bcrepeauac/Current-DAC-Shield/README.md

# Current-DAC-Shield
Current D-A Shield for Arduino
