bcrepeauac/Current-DAC-Shield/Board Files/Rev B/DAC Shield Rev B.pdf

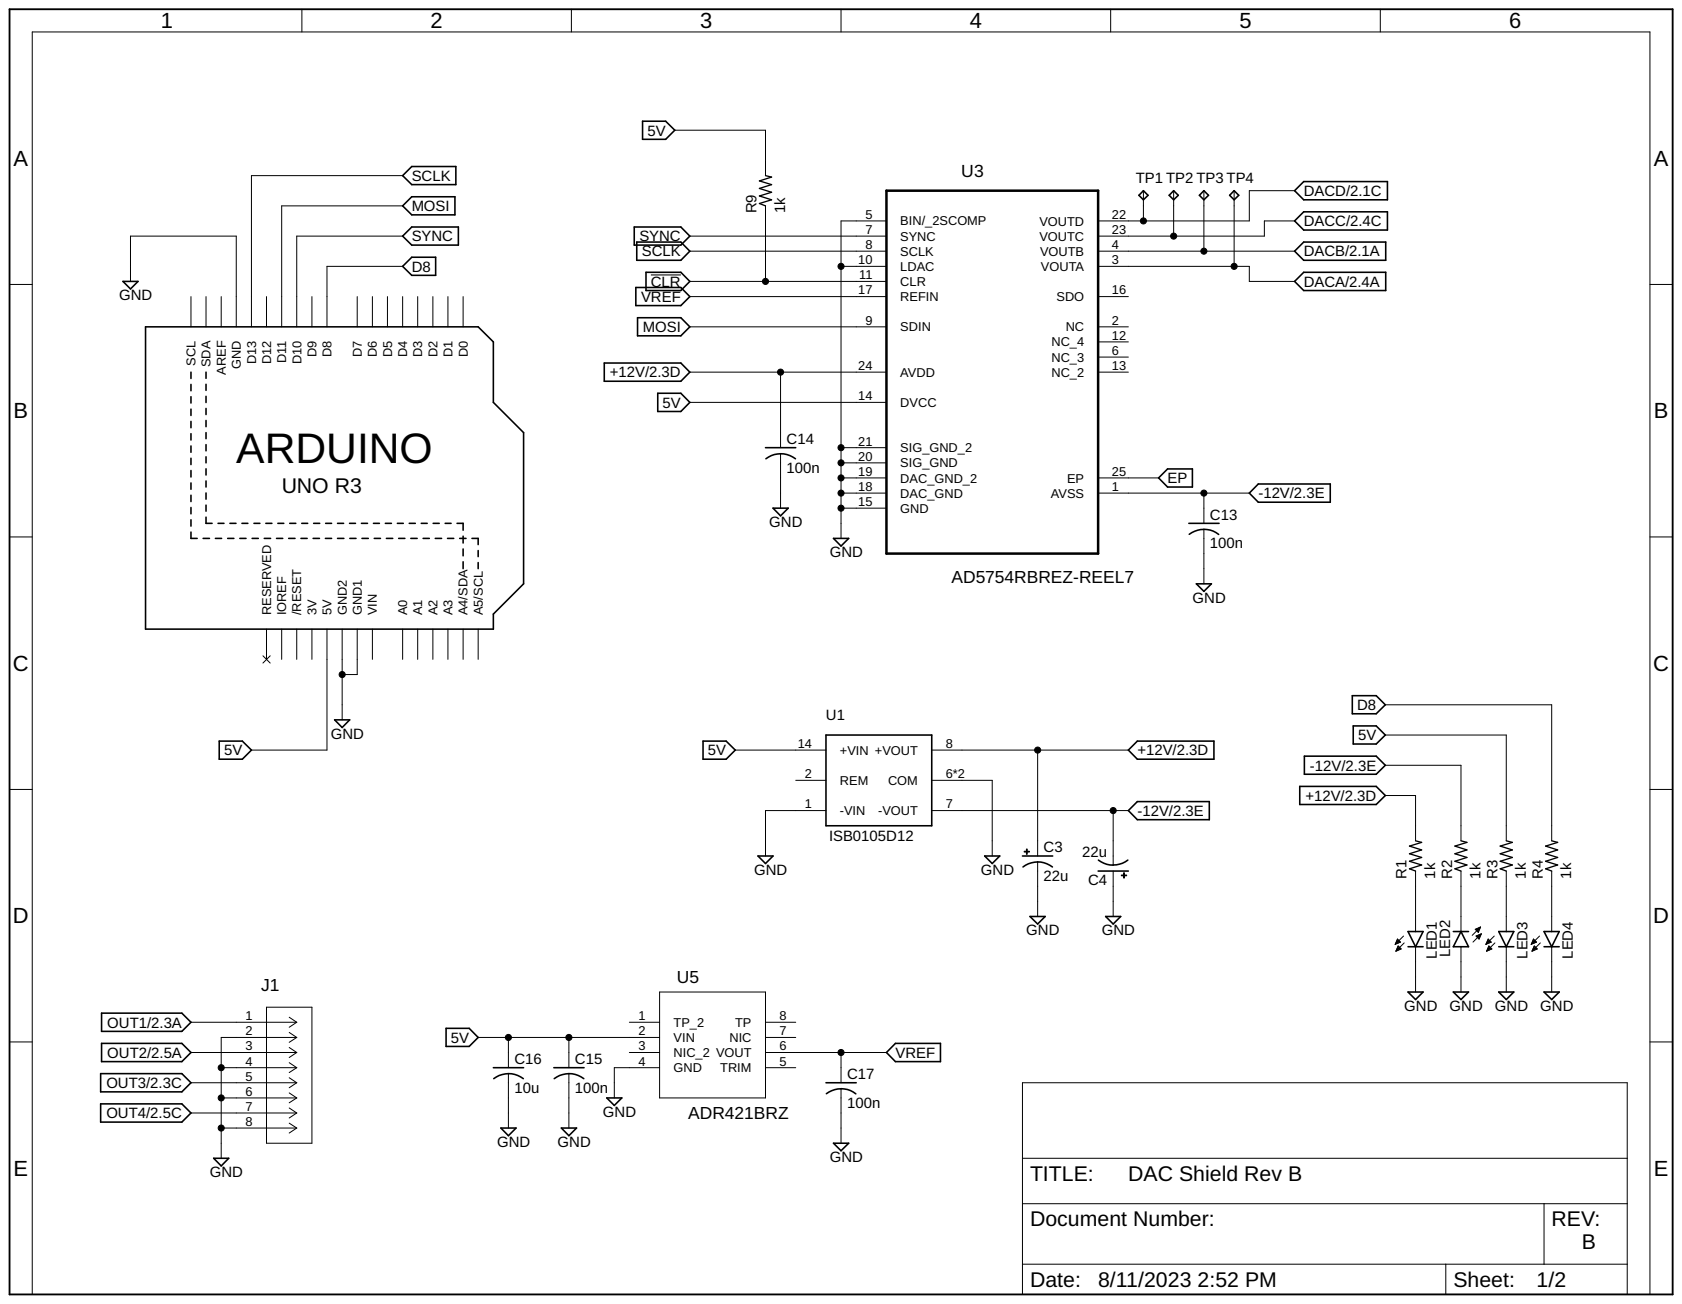
[picture p1: page 1]

GND GND

Document Number: | REV: B

Date: 8/11/2023 2:52 PM | Sheet: 1/2

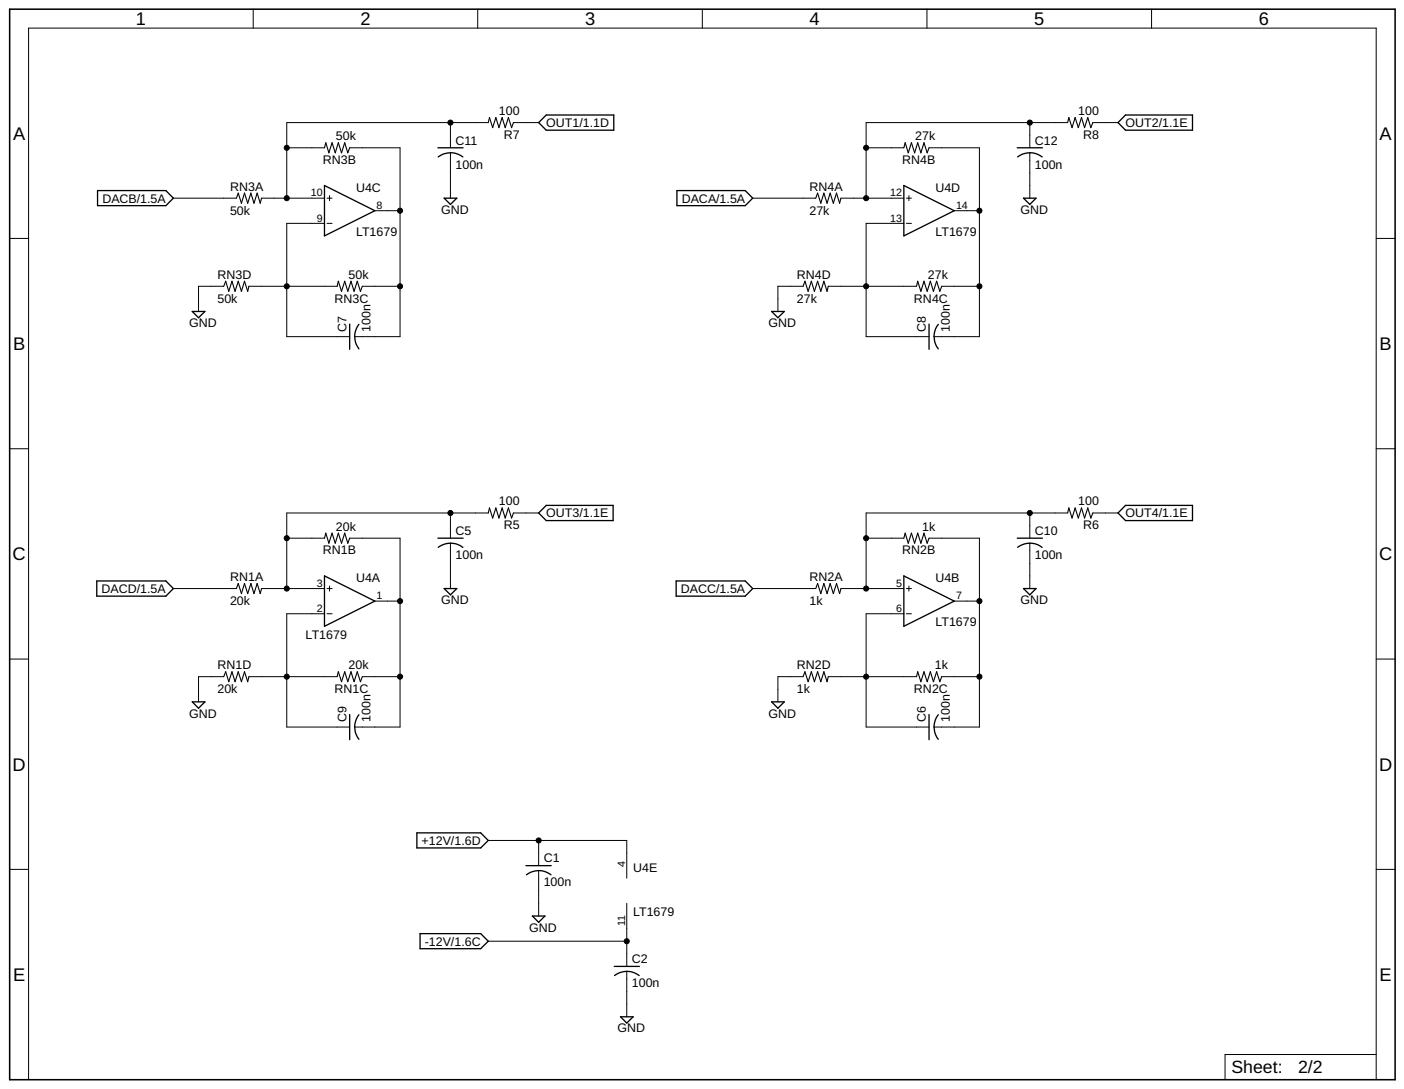
[picture p2: page 2]
