bcrepeauac/Current-DAC-Shield/Board Files/Rev -/DAC Shield.pdf

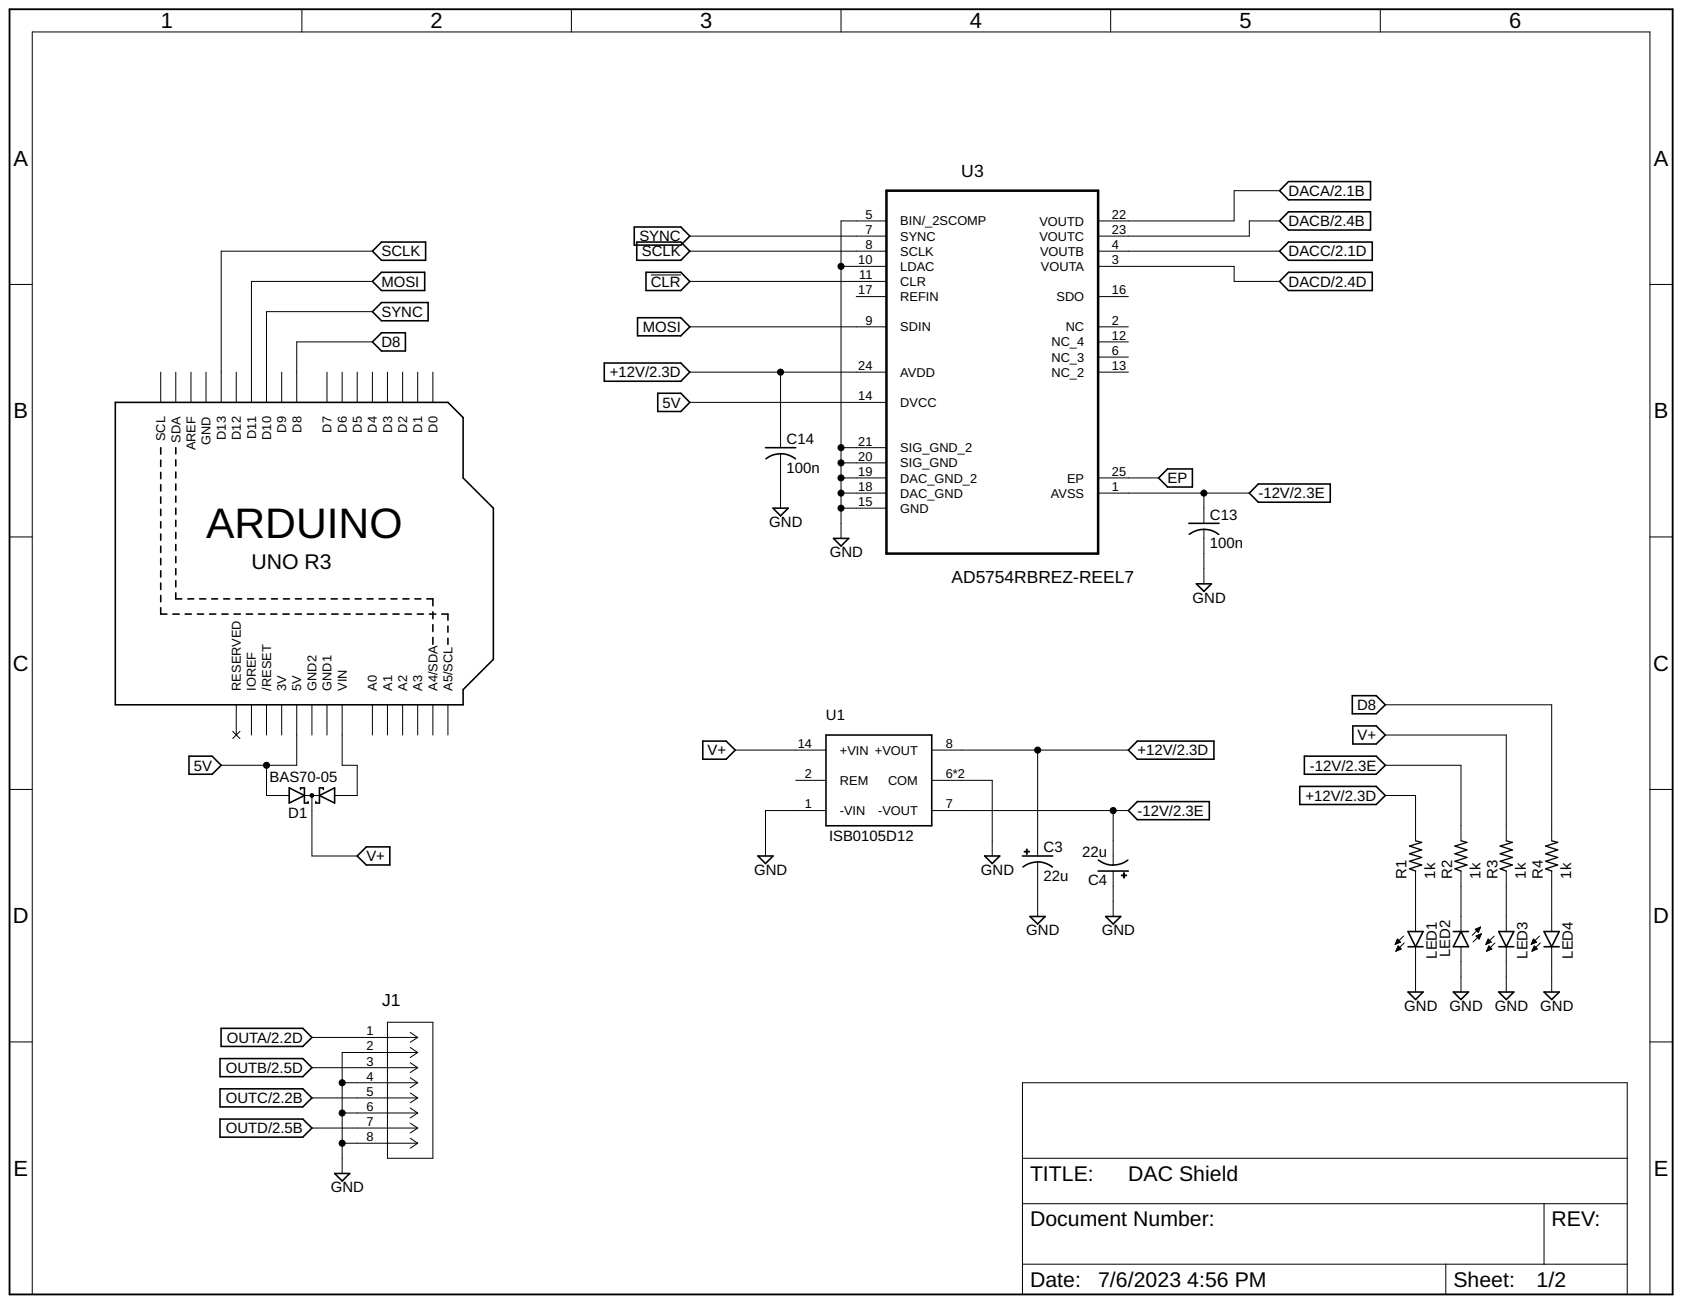
[picture p3: page 1]

GND GND

Document Number: | REV:

Date: 7/6/2023 4:56 PM | Sheet: 1/2
