bcrepeauac/Current-DAC-Shield/Board Files/Rev A/DAC Shield Rev A.pdf

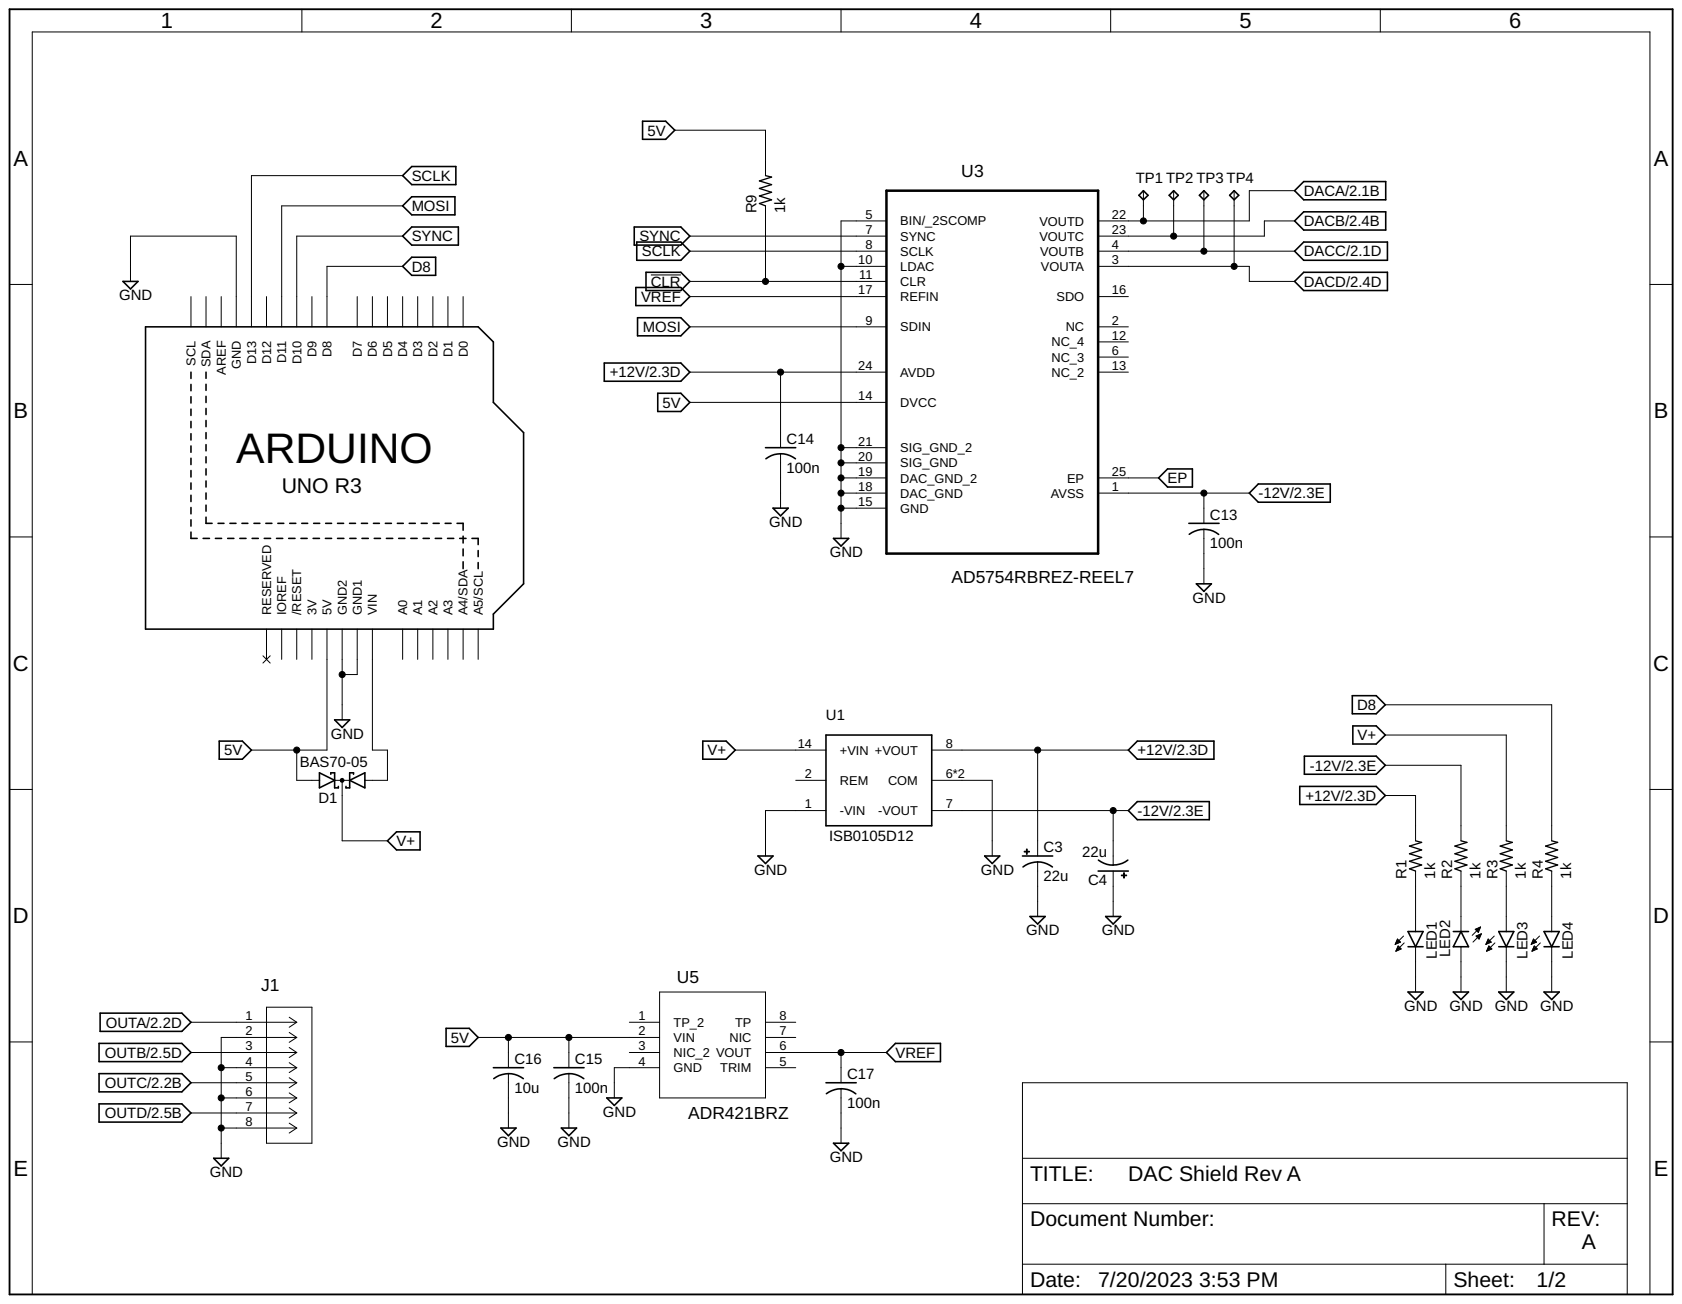
[picture p4: page 1]

GND GND

Document Number: | REV: A

Date: 7/20/2023 3:53 PM | Sheet: 1/2

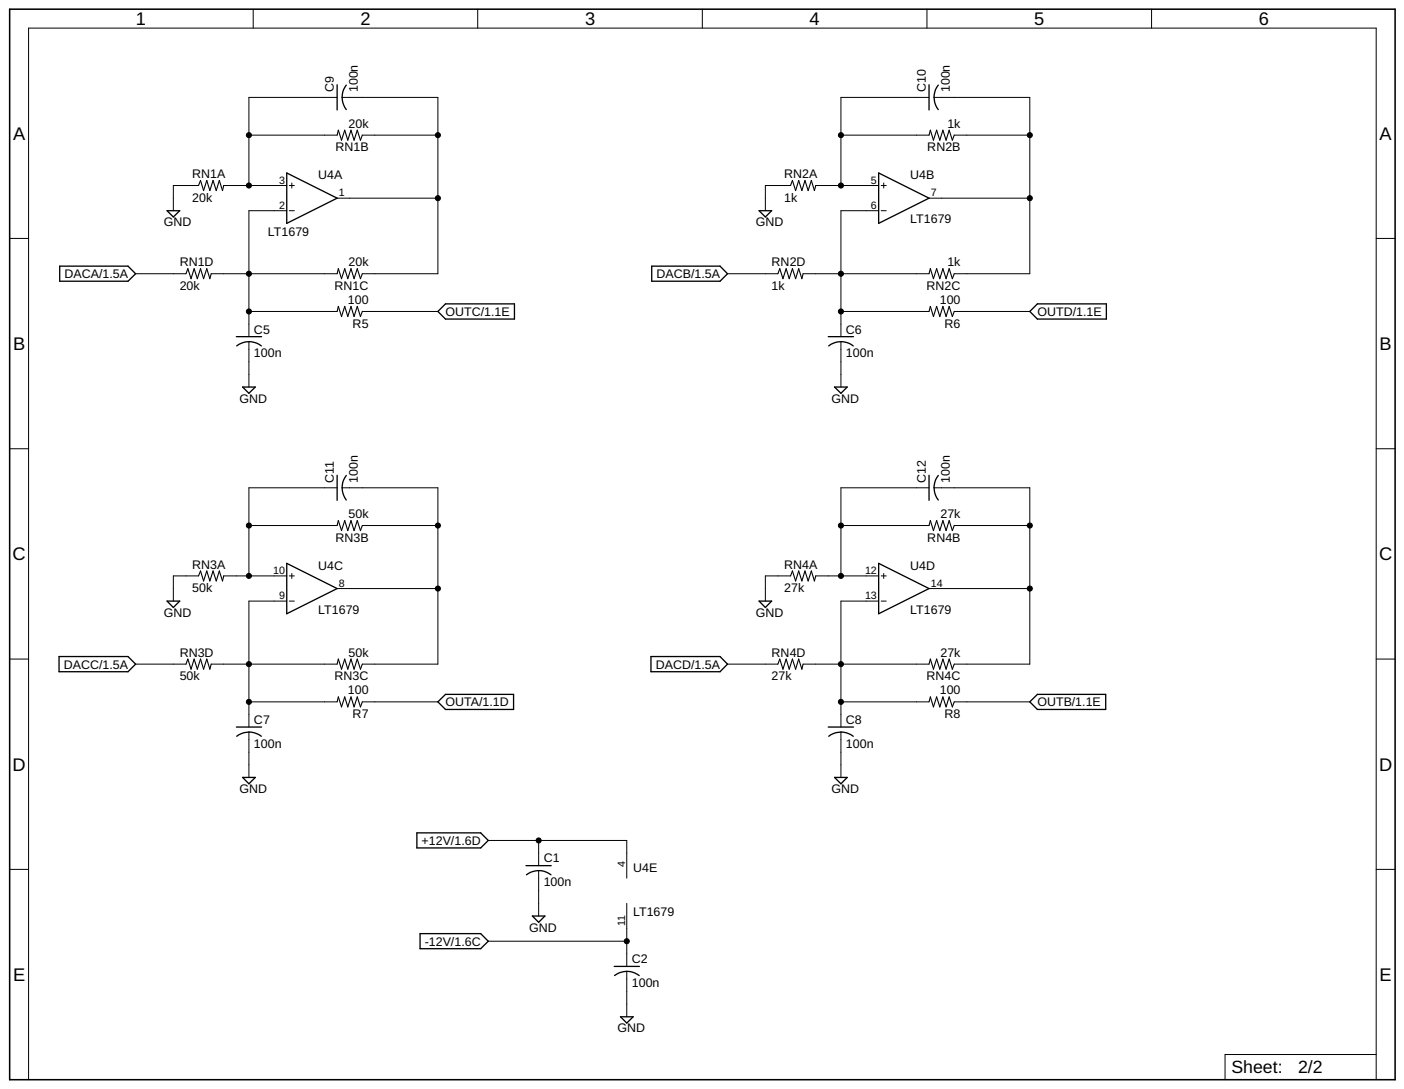
[picture p5: page 2]
