bcrepeauac/Current-DAC-Shield/Board Files/Rev -/DAC Shield.brd

## EAGLE design Board Files/Rev -/DAC Shield.brd (2023-07-11)

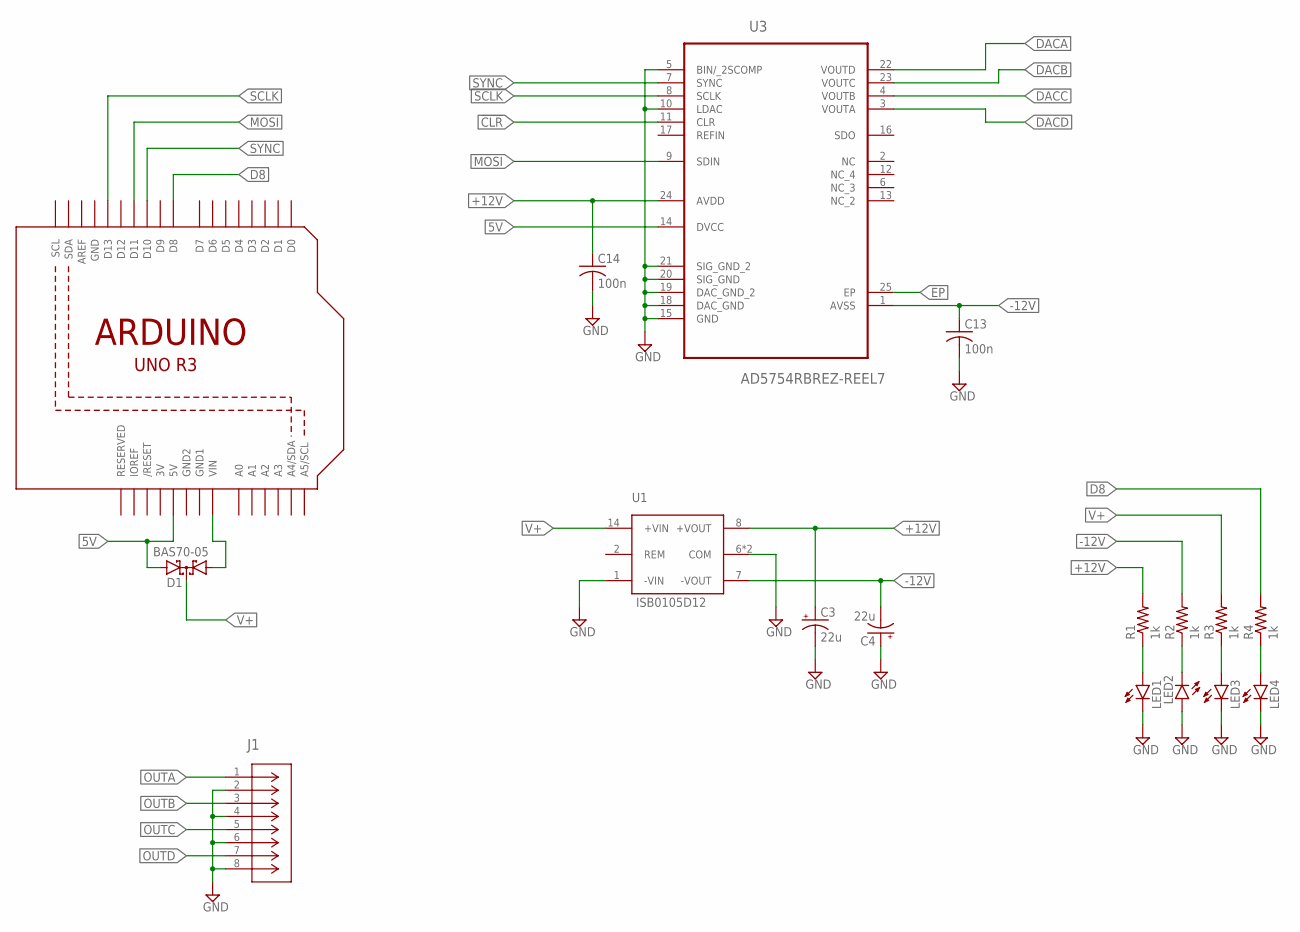
[picture p6: schematic DAC Shield.sch, sheet 1]

Parts:
C3, C4: 22u; C/6032-28W
C13, C14: 100n; C0805
D1: BAS70-05; SOT23
J1: OSTVN08A150; CONN_OSTVN08A150_OST
LED1, LED2, LED3, LED4: LEDCHIPLED_0805; CHIPLED_0805
R1, R2, R3, R4: 1k; R0805
U1: ISB0105D12; SOP254P1860X845-14L
U2: ARDUINOR3-BPLACE
U3: AD5754RBREZ-REEL7; SOP65P640X120-25N

Connections:
3V: U2.3V
5V: D1.2 (A2), U2.5V, U3.14 (DVCC)
!CLR: U3.11 (CLR)
+12V: C3.+, C14.1, R1.2, U1.8 (+VOUT), U3.24 (AVDD); also elsewhere on the board
-12V: C4.-, C13.1, R2.2, U1.7 (-VOUT), U3.1 (AVSS); also elsewhere on the board
D8: R4.2, U2.D8
DACA: U3.22 (VOUTD); also elsewhere on the board
DACB: U3.23 (VOUTC); also elsewhere on the board
DACC: U3.4 (VOUTB); also elsewhere on the board
DACD: U3.3 (VOUTA); also elsewhere on the board
EP: U3.25 (EP)
GND: C3.-, C4.+, C13.2, C14.2, J1.2, J1.4, J1.6, J1.8, LED1.C, LED2.A, LED3.C, LED4.C, U1.1 (-VIN), U1.6 (COM), U1.9 (COM), U2.GND, U3.5 (BIN/_2SCOMP), U3.10 (LDAC), U3.15 (GND), U3.18 (DAC_GND), U3.19 (DAC_GND_2), U3.20 (SIG_GND), U3.21 (SIG_GND_2); also elsewhere on the board
GND1: U2.GND1
GND2: U2.GND2
MOSI: U2.D11, U3.9 (SDIN)
unnamed: D1.1 (A1), U2.VIN
unnamed: LED1.A, R1.1
unnamed: LED2.C, R2.1
unnamed: LED3.A, R3.1
unnamed: LED4.A, R4.1
OUTA: J1.1; also elsewhere on the board
OUTB: J1.3; also elsewhere on the board
OUTC: J1.5; also elsewhere on the board
OUTD: J1.7; also elsewhere on the board
SCLK: U2.D13, U3.8 (SCLK)
SYNC: U2.D10, U3.7 (SYNC)
V+: D1.3 (C), R3.2, U1.14 (+VIN)

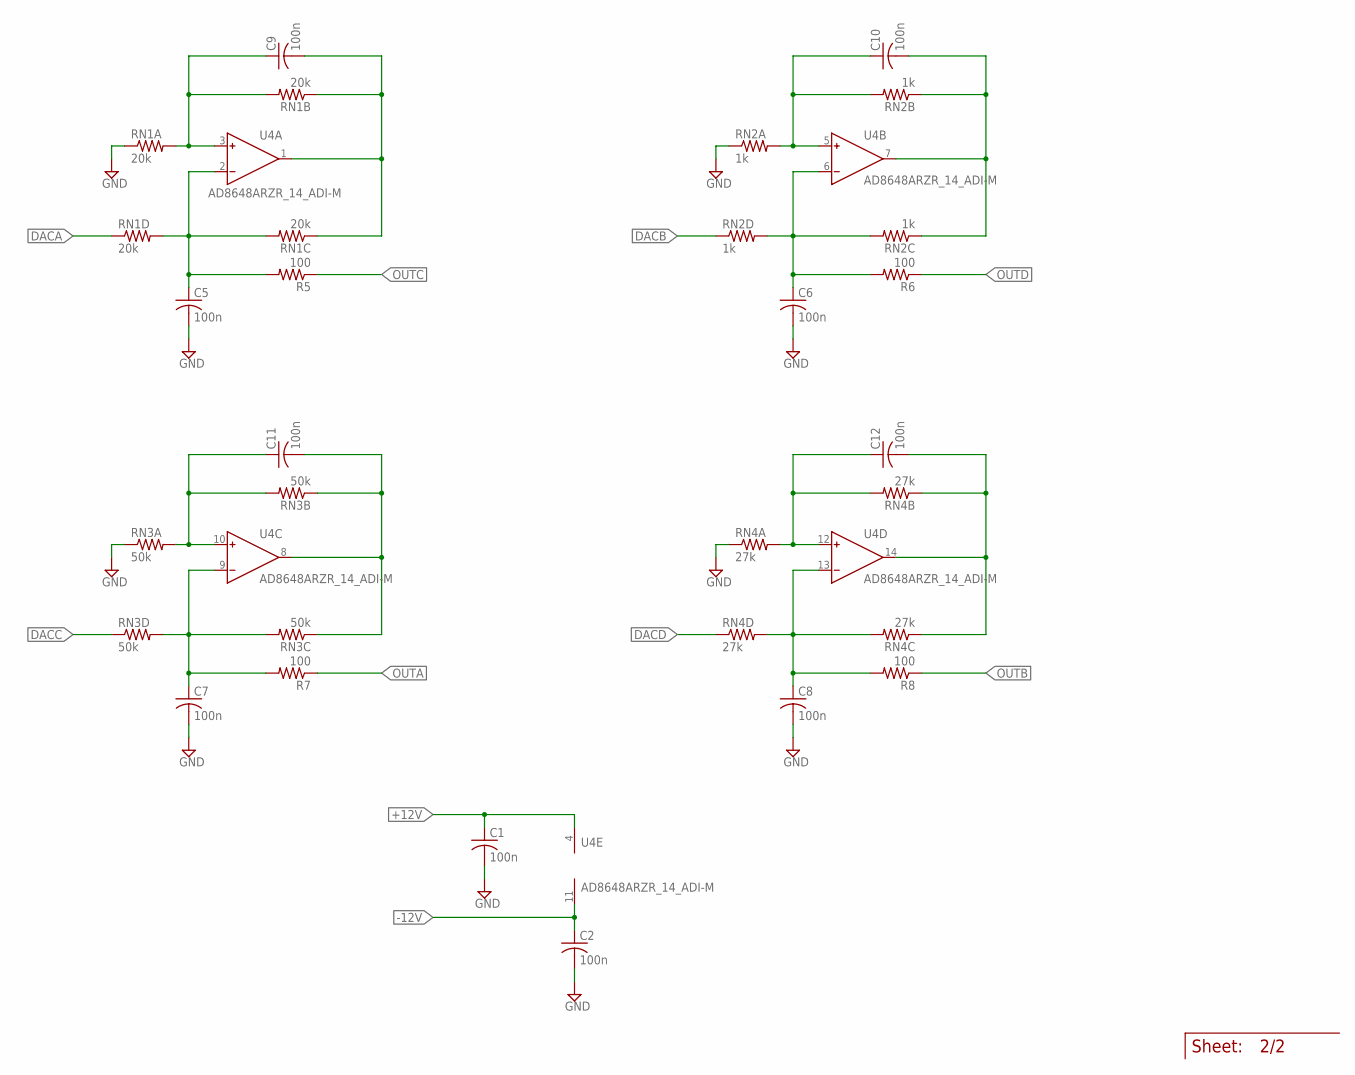
[picture p7: schematic DAC Shield.sch, sheet 2]

Parts:
C1, C2, C5, C6, C7, C8, C9, C10, C11, C12: 100n; C0805
R5, R6, R7, R8: 100; R0805
RN1: 20k; RESCAV80P320X150X55-8N
RN2: 1k; RESCAV80P320X150X55-8N
RN3: 50k; RESCAV80P320X150X55-8N
RN4: 27k; RESCAV80P320X150X55-8N
U4: AD8648ARZR_14_ADI-M; R_14_ADI-M

Connections:
+12V: C1.1, U4.4 (V+); also elsewhere on the board
-12V: C2.1, U4.11 (V-); also elsewhere on the board
DACA: RN1.4 (1); also elsewhere on the board
DACB: RN2.4 (1); also elsewhere on the board
DACC: RN3.4 (1); also elsewhere on the board
DACD: RN4.4 (1); also elsewhere on the board
GND: C1.2, C2.2, C5.2, C6.2, C7.2, C8.2, RN1.1, RN2.1, RN3.1, RN4.1; also elsewhere on the board
unnamed: C10.1, RN2.7 (2), RN2.8 (2), U4.5 (IN+)
unnamed: C9.1, RN1.7 (2), RN1.8 (2), U4.3 (IN+)
unnamed: C9.2, RN1.2 (1), RN1.3 (1), U4.1 (OUT)
unnamed: C10.2, RN2.2 (1), RN2.3 (1), U4.7 (OUT)
unnamed: C11.1, RN3.7 (2), RN3.8 (2), U4.10 (IN+)
unnamed: C11.2, RN3.2 (1), RN3.3 (1), U4.8 (OUT)
unnamed: C12.1, RN4.7 (2), RN4.8 (2), U4.12 (IN+)
unnamed: C12.2, RN4.2 (1), RN4.3 (1), U4.14 (OUT)
unnamed: C5.1, R5.2, RN1.5 (2), RN1.6 (2), U4.2 (IN-)
unnamed: C6.1, R6.2, RN2.5 (2), RN2.6 (2), U4.6 (IN-)
unnamed: C7.1, R7.2, RN3.5 (2), RN3.6 (2), U4.9 (IN-)
unnamed: C8.1, R8.2, RN4.5 (2), RN4.6 (2), U4.13 (IN-)
OUTA: R7.1; also elsewhere on the board
OUTB: R8.1; also elsewhere on the board
OUTC: R5.1; also elsewhere on the board
OUTD: R6.1; also elsewhere on the board

Notes on the sheet:
Sheet:

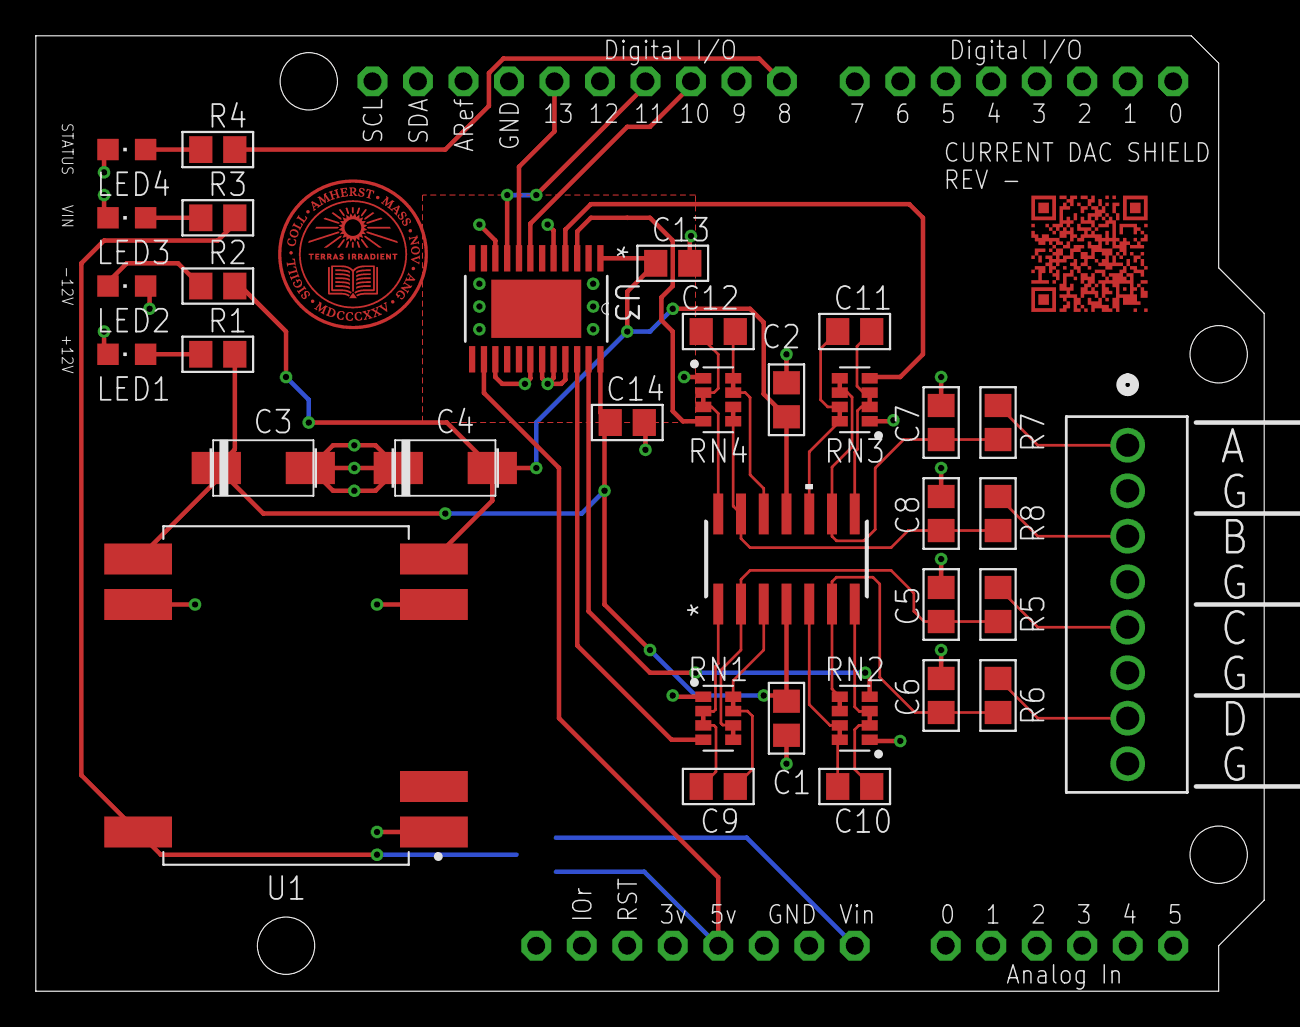
[picture p8: board DAC Shield.brd from above]

Board: 2 copper layers, 68.6 x 53.3 mm, 36 parts (1 on the bottom side), 34 nets.
