bcrepeauac/Current-DAC-Shield/(commit log)

2023-07-12 Added SPI Code
2023-08-29 Added rev B
    [DAC Shield Rev A.brd, DAC Shield Rev A.csv, DAC Shield Rev A.sch, DAC Shield Rev B.brd, DAC Shield Rev B.csv, DAC Shield Rev B.sch, DAC Shield.brd, DAC Shield.csv]
