bcrepeauac/Current-DAC-Shield/(notices)

Notices in the files:
parts and their libraries:
analog: COPYRIGHT: Copyright (C) 2023 Ultra Librarian. All rights reserved.
